LenShustek/Theremin_digitizer/front_sm.jpg

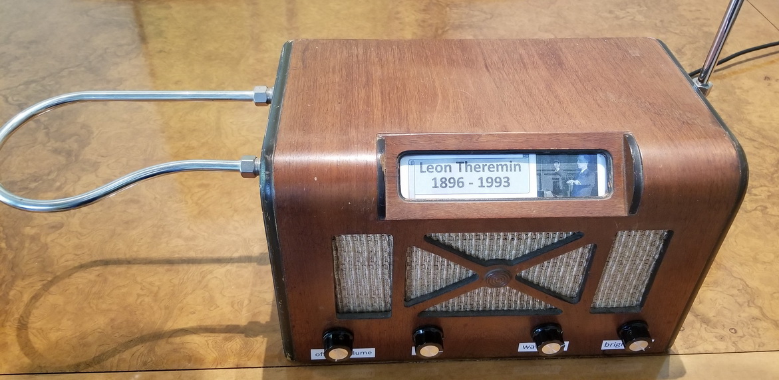
front_sm.jpg
