LenShustek/Theremin_digitizer/back_sm.jpg

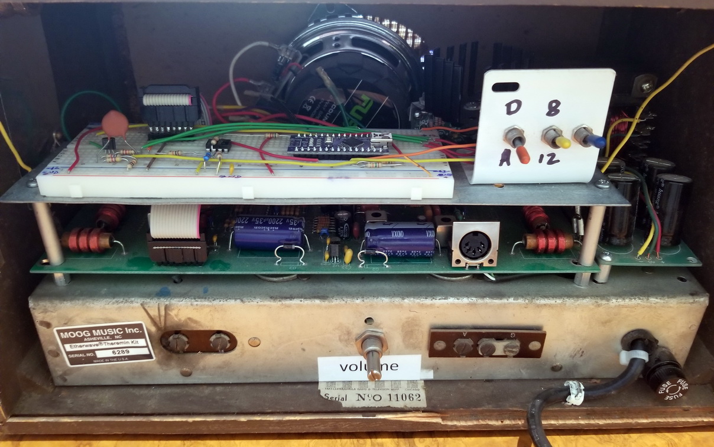
back_sm.jpg
