LenShustek/Theremin_digitizer/schematic.pdf

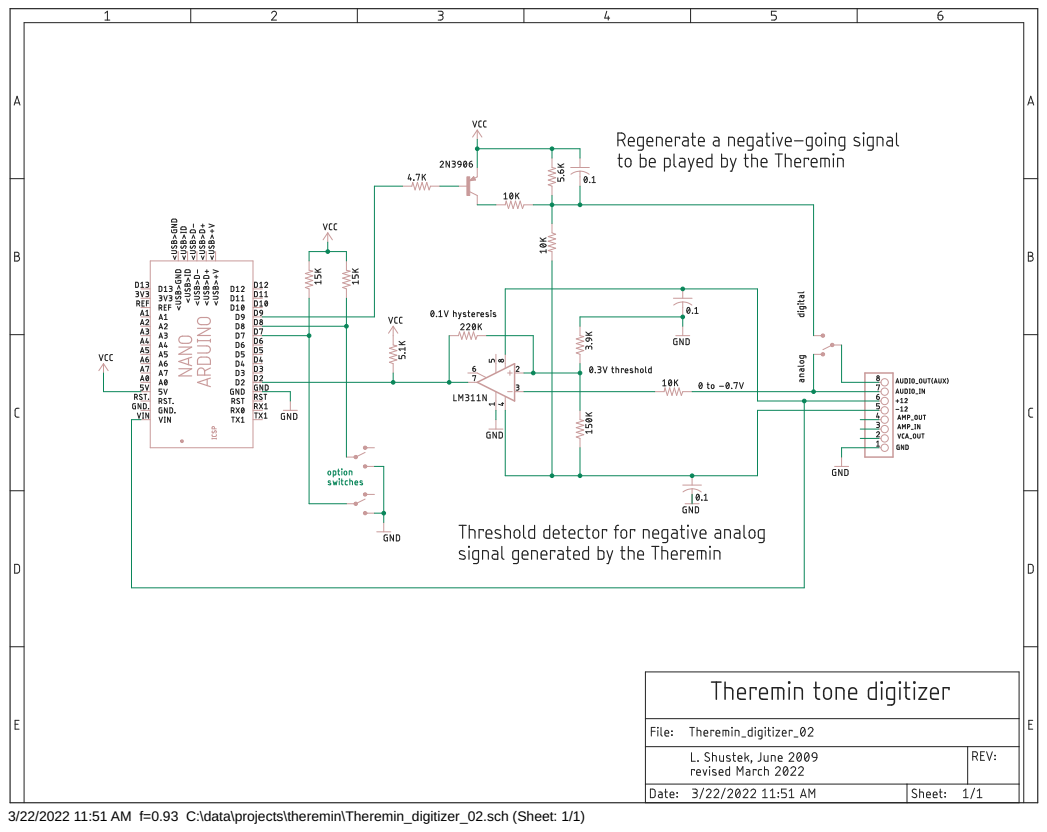
[picture p3: page 1]

3/22/2022 11:51 AM f=0.93 C:\data\projects\theremin\Theremin_digitizer_02.sch (Sheet: 1/1)
